bytesontherocks/AQS-X01/serial_debug-gui/README.md

# AQS-X01 GUI for serial debug port

### Overview:
With a TTL-USB adaptor connect to CN26 pin 1 (GND) and 3 (TX). AQS-X01 updates co2, co2 average, temperature and humidity every 5 seconds.
Ref: https://github.com/bytesontherocks/AQS-X01/blob/master/Board%20and%20microcontroller/AQS-X01_Schematics.PDF

## Using poetry
poetry install
poetry run python main.py
