bytesontherocks/AQS-X01/Board and microcontroller/AQS-X01_Schematics.PDF

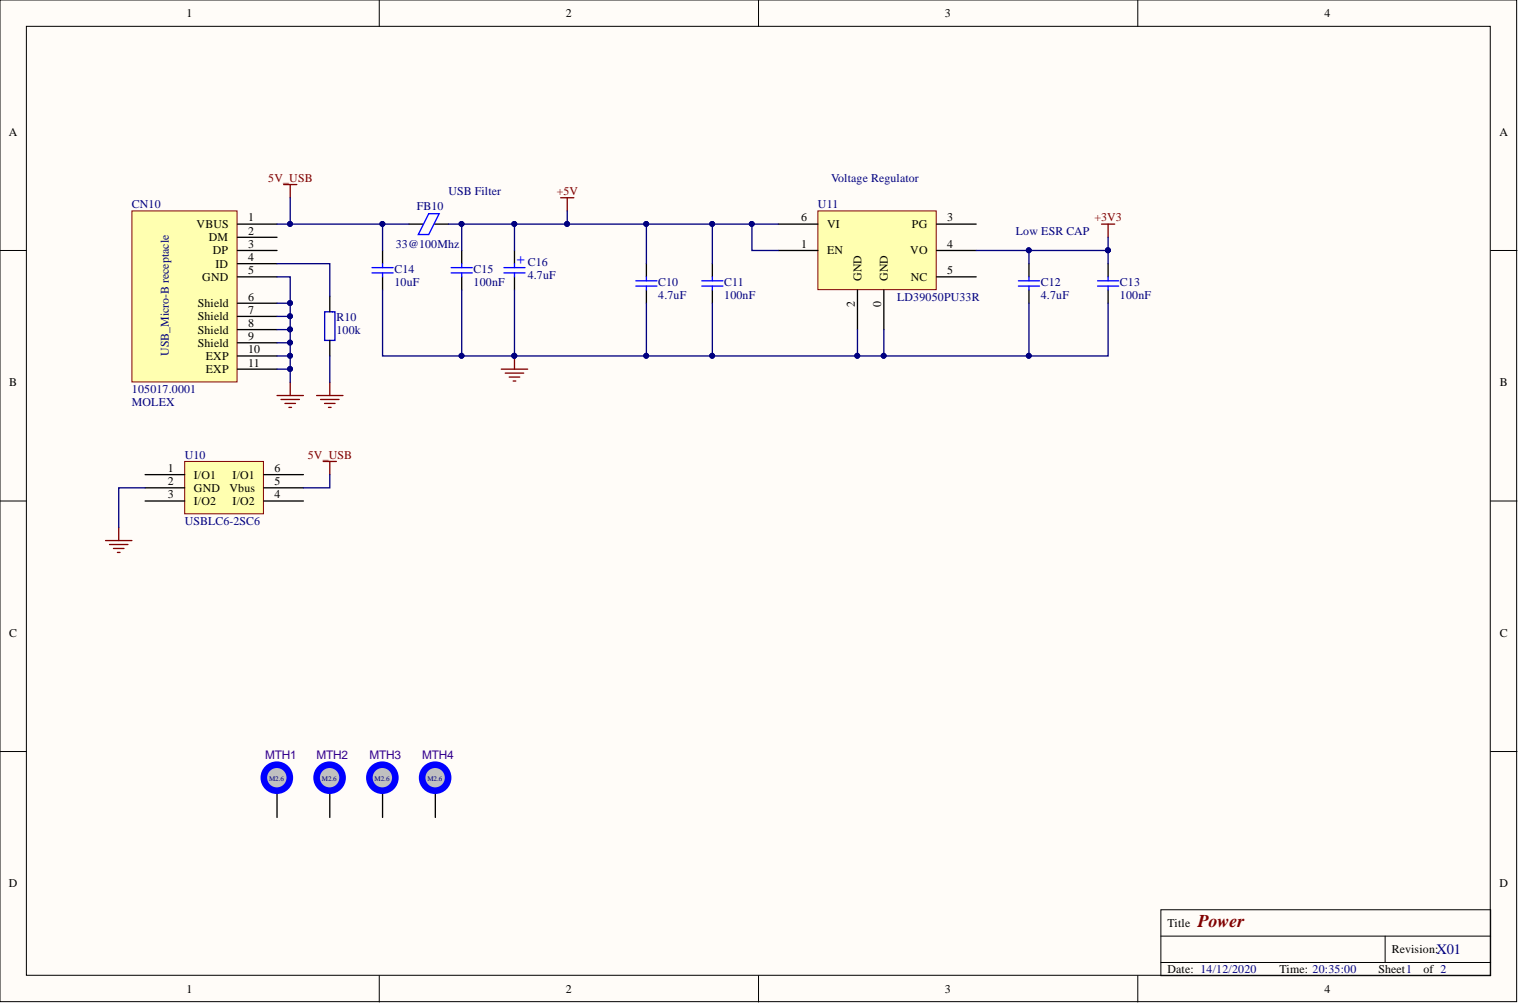
[picture p4: page 1]

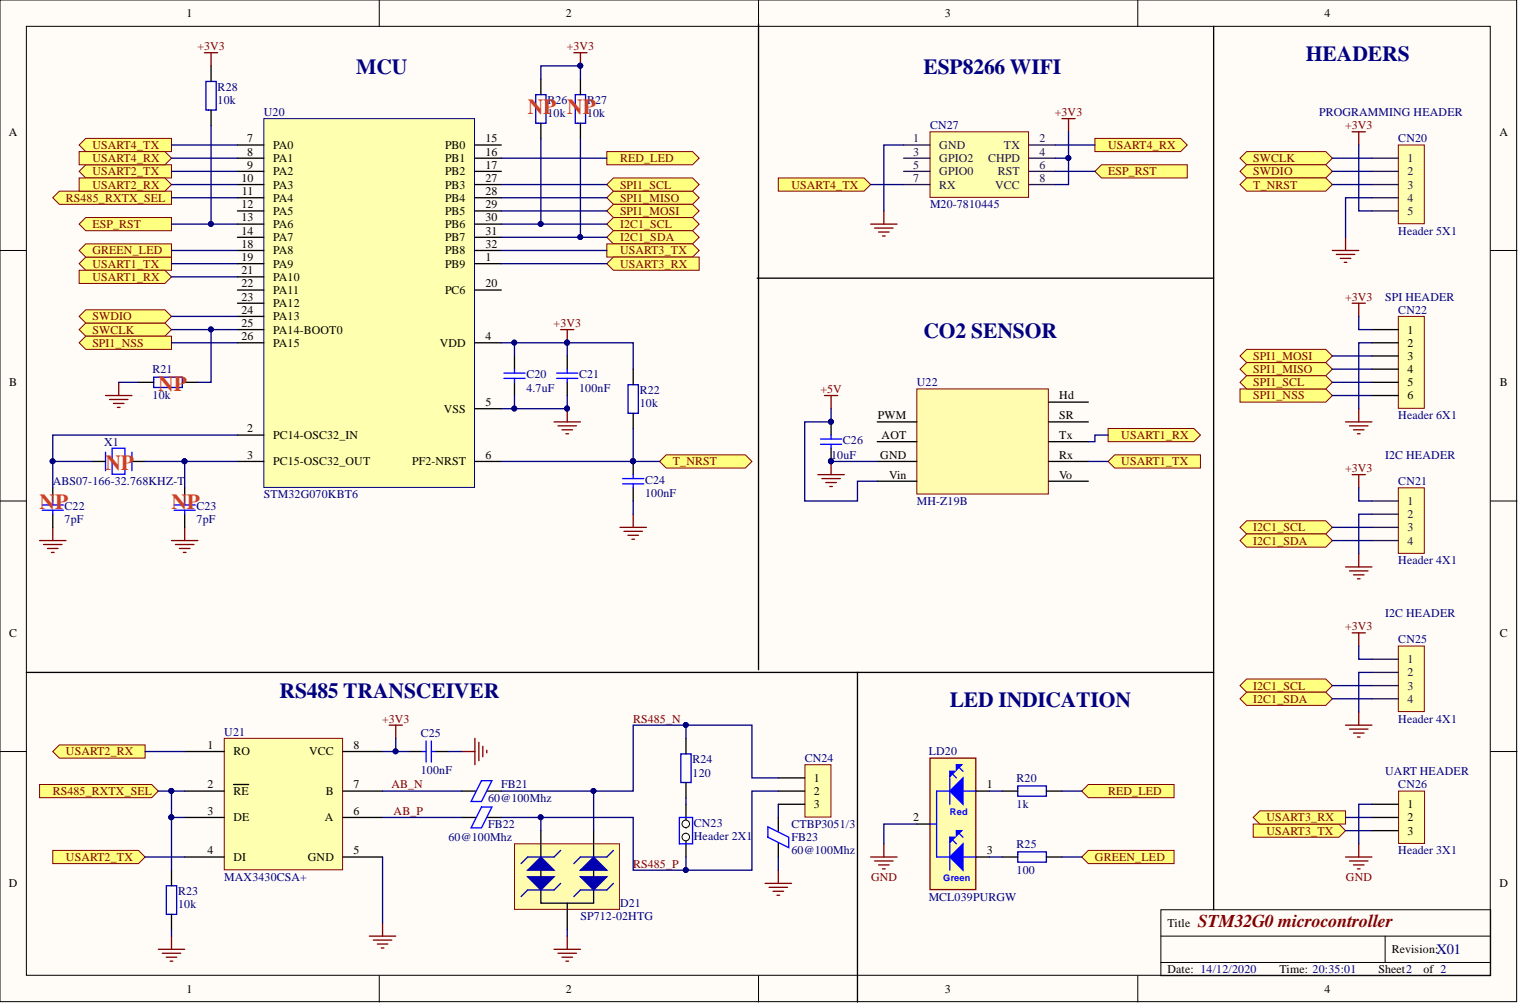
[picture p5: page 2]
