bytesontherocks/AQS-X01/Board and microcontroller/AQS-X01.ioc

Mcu.UserName=STM32G070KBTx
PA0.Signal=USART4_TX
PA1.Signal=USART4_RX
PA10.Signal=USART1_RX
PA13.Signal=SYS_SWDIO
PA14-BOOT0.Signal=SYS_SWCLK
PA2.Signal=USART2_TX
PA3.Signal=USART2_RX
PA4.GPIO_Label=RS485_TXRX
PA4.Signal=GPIO_Output
PA6.GPIO_Label=ESP_RST
PA6.Signal=GPIO_Output
PA8.GPIO_Label=GREEN_LED
PA8.Signal=S_TIM1_CH1
PA9.Signal=USART1_TX
PB1.GPIO_Label=RED_LED
PB1.Signal=S_TIM14_CH1
PB6.Signal=I2C1_SCL
PB7.Signal=I2C1_SDA
PB8.Signal=USART3_TX
PB9.Signal=USART3_RX
