bytesontherocks/AQS-X01/Wifi/Examples/mqtt/mqtt.h

#pragma once

#define uniqueClientID "example"

// using maqiatto as broker the topic contains your registered e-mail address
#define co2_topic "gmr/co2"
#define temp_topic "gmr/t"
#define hum_topic "gmr/h"
