bytesontherocks/AQS-X01/Wifi/Examples/mqtt/modbusRegisters.h

#pragma once

constexpr uint16_t InputRegisterCo2   		= UINT16_C(0);
constexpr uint16_t InputRegisterCo2Avg  	= UINT16_C(1);
constexpr uint16_t InputRegisterTemp  		= UINT16_C(2);
constexpr uint16_t InputRegisterHum   		= UINT16_C(3);
constexpr uint16_t InputRegisterTvoc  		= UINT16_C(4);
constexpr uint16_t InputRegistereCo2  		= UINT16_C(5);
constexpr uint16_t InputRegisterTvocAvg 	= UINT16_C(6);
constexpr uint16_t InputRegistereCo2Avg 	= UINT16_C(7);
constexpr uint16_t InputRegisterTvocBase  	= UINT16_C(8);
constexpr uint16_t InputRegistereCo2Base  	= UINT16_C(9);
constexpr uint16_t InputRegisterEthanolRaw 	= UINT16_C(10);
constexpr uint16_t InputRegisterH2Raw 		= UINT16_C(11);
constexpr uint16_t InputRegisterFwVersion   = UINT16_C(12);
