bytesontherocks/AQS-X01/(commit log)

2020-12-26 add schematics
2020-12-27 update self heating documentation
2021-01-02 update info about sensors
2021-01-18 Added manual calibration Port B Pin 5 when connected to ground
2021-02-06 Added manual calibration and possibility to reenable autocal
2021-02-15 Manual calibration documented
2023-11-19 poetry supporte and example for commanding remote relay from http POST
2023-11-19 SCD4X sensor support and fw added
2023-11-20 add ref to schematics
